mferrantini/vasovivo/hardware.html

VasoVivo

Home

Guida

# Hardware

Elenco della scheda e dei sensori utilizzabili in VasoVivo. Per ogni sensore trovi nella repository documentazione, schema di collegamento e uno sketch di esempio per ESP32.

### 🧩 Breadboard 400 punti

- Prototipazione · collegamenti
  Base per montare e collegare scheda e sensori in fase di prototipo, senza saldature.
  Acquista su Amazon → (https://amzn.eu/d/0fgUUkNM)

### 🔌 ESP32-WROOM-32

- Microcontrollore · Wi-Fi · Bluetooth
  Scheda principale del progetto: collega i sensori e gestisce lettura e invio dei dati.
  Acquista su Amazon → (https://amzn.eu/d/00sh8ijS)

### 🌿 ENS160 + AHT21

- CO₂eq · TVOC · temperatura · umidità aria
  Modulo combinato per monitorare qualità dell'aria e condizioni ambientali nel barattolo.
  Documentazione su GitHub → (https://github.com/mferrantini/vasovivo/tree/main/sensors/ens160-aht21) Acquista su Amazon → (https://amzn.eu/d/09YsVM7w)

### 🌡️ DHT22

- Temperatura · umidità aria
  Alternativa consigliata per misurare temperatura e umidità dell'aria con maggiore precisione.
  Documentazione su GitHub → (https://github.com/mferrantini/vasovivo/tree/main/sensors/dht22) Acquista su Amazon → (https://amzn.eu/d/05ty8ZEh)

### 🌡️ DHT11

- Temperatura · umidità aria
  Alternativa economica per temperatura e umidità dell'aria, adatta a un primo approccio al progetto.
  Documentazione su GitHub → (https://github.com/mferrantini/vasovivo/tree/main/sensors/dht11) Acquista su Amazon → (https://amzn.eu/d/0f7JwCVp)

### 💧 Sensore capacitivo

- Umidità substrato
  Lama PCB capacitiva resistente alla corrosione: misura l'umidità della zolletta senza elettrodi esposti.
  Documentazione su GitHub → (https://github.com/mferrantini/vasovivo/tree/main/sensors/capacitive-moisture) Acquista su Amazon → (https://amzn.eu/d/0f9MrNnY)

### 🌱 DS18B20

- Temperatura substrato
  Sonda impermeabile per la temperatura interna al substrato, complementare alla temperatura dell'aria.
  Documentazione su GitHub → (https://github.com/mferrantini/vasovivo/tree/main/sensors/ds18b20) Acquista su Amazon → (https://amzn.eu/d/01pL8143)

### ☀️ Fotoresistenza (LDR)

- Luminosità
  Rileva la luce ambientale per verificare l'esposizione e correlarla con l'andamento della coltivazione.
  Documentazione su GitHub → (https://github.com/mferrantini/vasovivo/tree/main/sensors/ldr) Acquista su Amazon → (https://amzn.eu/d/06DKjILB)

### 💡 GY-302 BH1750FVI

- Intensità luminosa · lux
  Modulo I²C per la luce ambientale, in lux. Misura diretta dell'intensità, a differenza della fotoresistenza.
  Documentazione su GitHub → (https://github.com/mferrantini/vasovivo/tree/main/sensors/bh1750) Acquista su Amazon → (https://amzn.eu/d/02b8TlgW)

← Torna alla home

 Progetto open source · Vedi su GitHub (https://github.com/mferrantini/vasovivo) · Instagram (https://www.instagram.com/vasovivo_/) · LinkedIn (https://www.linkedin.com/in/marcoferrantini/) · Maker Faire Roma 2026 - Stand V13
