mferrantini/vasovivo/prints/eklatant/Flangia.stl

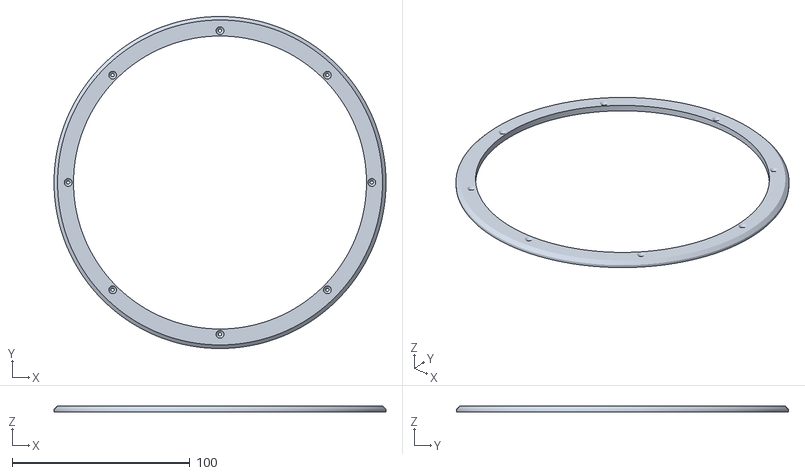
[picture p1: CAD file, 2026-10-23]
prints/eklatant/Flangia.stl
187.0 x 187.0 x 3.50
