mferrantini/vasovivo/prints/eklatant/Manopola.stl

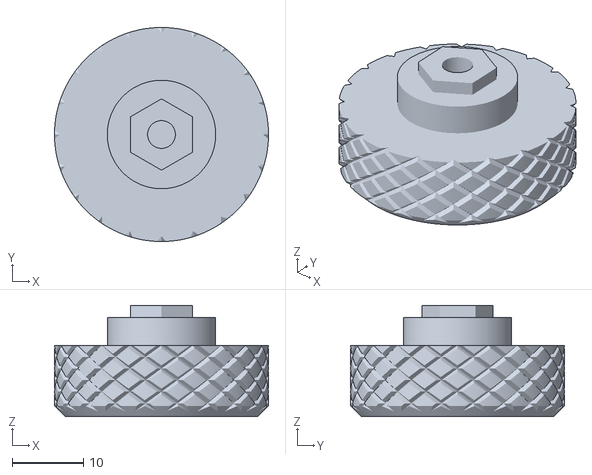
[picture p2: CAD file, 2026-10-23]
prints/eklatant/Manopola.stl
30.0 x 30.0 x 15.6
