mferrantini/vasovivo/prints/eklatant/Coperchio.stl

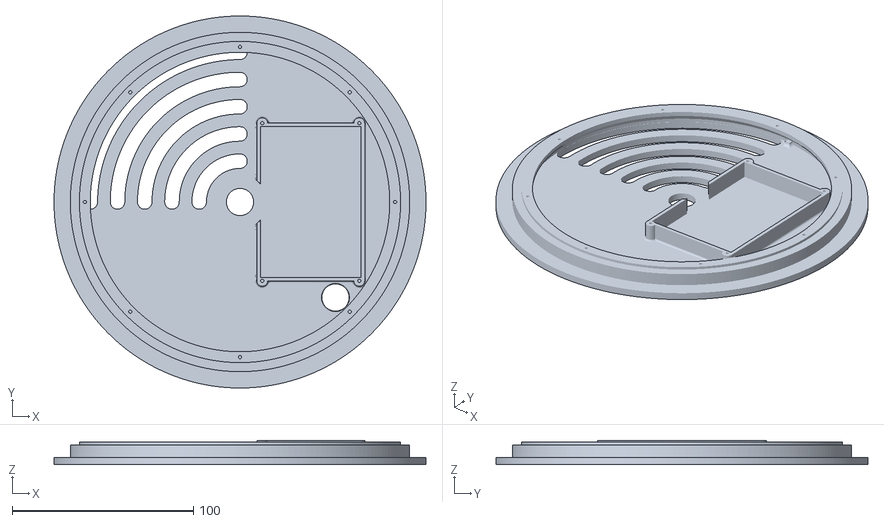
[picture p3: CAD file, 2026-10-23]
prints/eklatant/Coperchio.stl
205.0 x 205.0 x 13.5
