mferrantini/vasovivo/prints/eklatant/Paratia.stl

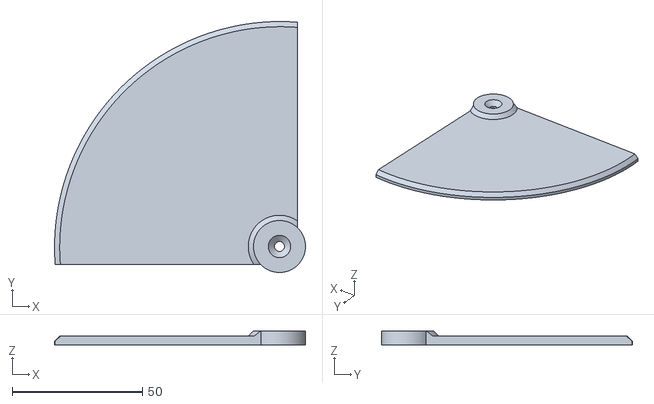
[picture p4: CAD file, 2026-10-23]
prints/eklatant/Paratia.stl
96.5 x 96.5 x 5.50
