mferrantini/vasovivo/prints/eklatant/README.md

# Coperchio per EKLATANT

Coperchio intelligente progettato per il barattolo **[IKEA EKLATANT](https://www.ikea.com/it/it/p/eklatant-contenitore-con-coperchio-vetro-trasparente-bambu-50621766/)** — contenitore di riferimento del progetto VasoVivo.

Sostituisce il coperchio in bambù originale e integra gli alloggiamenti per sensori e scheda ESP32.

---

## Compatibilità

- **IKEA EKLATANT** da 4.2 l — vetro trasparente / bambù

---

## Contenuto

| File | Descrizione |
|---|---|
| [`Coperchio.stl`](Coperchio.stl) | Coperchio principale |
| [`Flangia.stl`](Flangia.stl) | Flangia |
| [`Manopola.stl`](Manopola.stl) | Manopola |
| [`Paratia.stl`](Paratia.stl) | Paratia |

---

## Note di stampa

- Materiale consigliato: **PLA** o **PETG**
- Verifica orientamento e supporti nello slicer in base al pezzo
- Il coperchio originale in bambù non va in lavastoviglie: lo stesso vale per le parti stampate in PLA
