mferrantini/vasovivo/prints.html

VasoVivo

Home

Guida

# Stampa 3D

Modelli STL per i coperchi intelligenti di VasoVivo. Per ogni barattolo trovi nella repository documentazione e note di stampa; i file verranno aggiunti nelle rispettive cartelle.

### 🧩 Coperchio generico

- Adattabile · multi-barattolo
  Coperchio universale per barattoli con bocca circolare compatibile, utile per sperimentare con contenitori diversi.
  Documentazione su GitHub → (https://github.com/mferrantini/vasovivo/tree/main/prints/generic-lid)

### 🫙 Coperchio per EKLATANT

- IKEA EKLATANT · 4.2 l
  Coperchio su misura per il barattolo IKEA EKLATANT da 4.2 l, contenitore di riferimento del progetto.
  Documentazione su GitHub → (https://github.com/mferrantini/vasovivo/tree/main/prints/eklatant)

← Torna alla home

 Progetto open source · Vedi su GitHub (https://github.com/mferrantini/vasovivo) · Instagram (https://www.instagram.com/vasovivo_/) · LinkedIn (https://www.linkedin.com/in/marcoferrantini/) · Maker Faire Roma 2026 - Stand V13
