mferrantini/vasovivo/(commit log)

2026-06-22 Initial commit, sensors documentation and examples.
2026-06-23 Introducing 3D Printing section and files.
2026-10-03 Add mock dashboard UI and document the toolkit.
    Introduce a sample real-time interface and an elements glossary, with README guidance for building dashboards.
2026-10-19 Refactor sensor examples into shared headers; migrate to capacitive soil sensor.
    Each sensor example now reads through a dedicated header shared by the
    standalone sketch and the full examples. Replace the resistive fork
    sensor with a capacitive soil-moisture sensor and add the BH1750 light
    sensor.
2026-10-23 Add EKLATANT 3D print STL files.
    Include lid, flange, knob and partition models, and list them in the EKLATANT prints README.
2026-10-23 Add Google Analytics to the public site pages.
    Track visits on the main site and UI pages with GA4 measurement ID G-1X45DY3BR6.
2026-10-25 Add Italian/English UI with language switch and settings.
    Persist language, species and thresholds in localStorage, expose a flag switch and settings modal in the top bar, and apply translations across the site and dashboards.
2026-10-25 Document 5V power and calibration for the capacitive moisture v1.2.
    The module needs VIN at 5V to boot, while the analog out stays near 3V; update dry/wet ADC defaults from measured readings.
2026-10-25 Align Wi-Fi example wiring notes with the capacitive sensor at 5V.
    Clarify that I2C modules stay on 3.3V while the moisture probe uses VIN.
2026-10-26 Rebuild wifi-dashboard LittleFS data with settings and i18n.
    Include vv-settings.js in build-data.sh and regenerate the card dashboard bundle for the ESP32.
2026-10-26 Rebuild wifi-illustrated LittleFS data with settings and i18n.
    Include vv-settings.js in build-data.sh and regenerate the jar illustration bundle for the ESP32.
2026-10-26 Clarify project docs for Arduino IDE and ESP32-WROOM.
    Refresh READMEs for settings, STL status, moisture calibration, and LittleFS defaults so the guides match the current repo.
